HASHIBUZZAMAN-BHUIYAN/ARCEUS/PICTURES/BACK.jpg

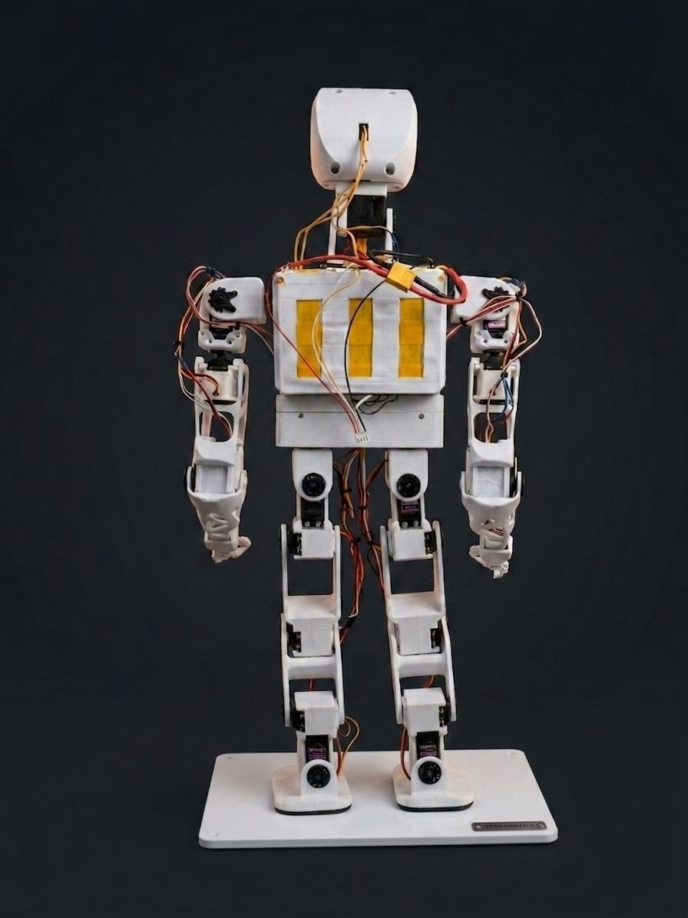
PICTURES/BACK.jpg
