HASHIBUZZAMAN-BHUIYAN/ARCEUS/PICTURES/FRONT.jpg

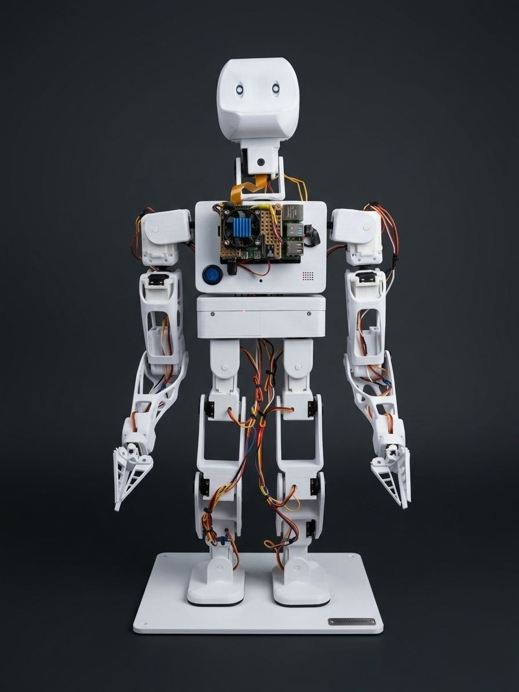
PICTURES/FRONT.jpg
