HASHIBUZZAMAN-BHUIYAN/ARCEUS/CIRCUIT DIAGRAM/ARCEUS_CIRCUIT_DIAGRAM.pptx

OLED GND -> Mpu9250 GND

Out(-) –> Raspberry pi GND

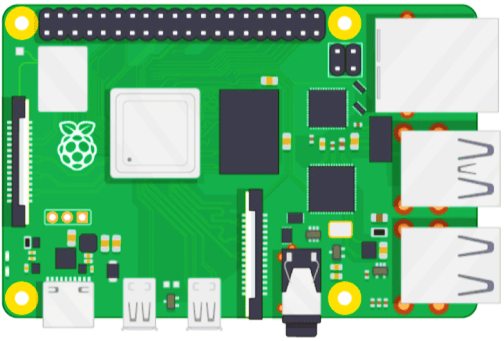
[picture p3: figure]
RASPBERRY PI 4 B SETTING UP Pdf Download | ManualsLib
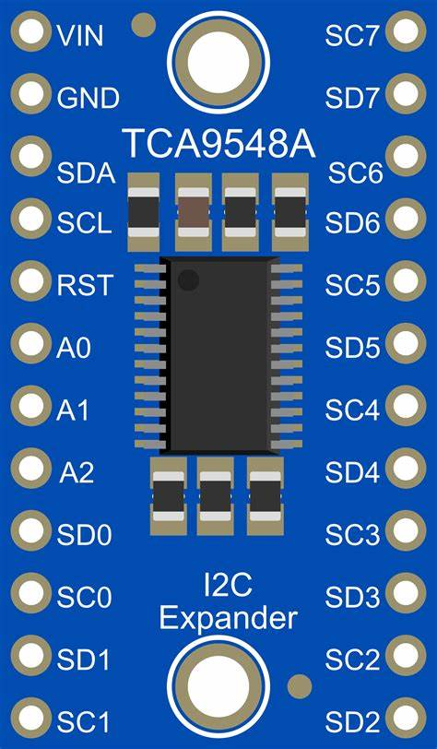
[picture p4: figure]

Sc5- PCA2 scl
Sd5- PCA2 sda

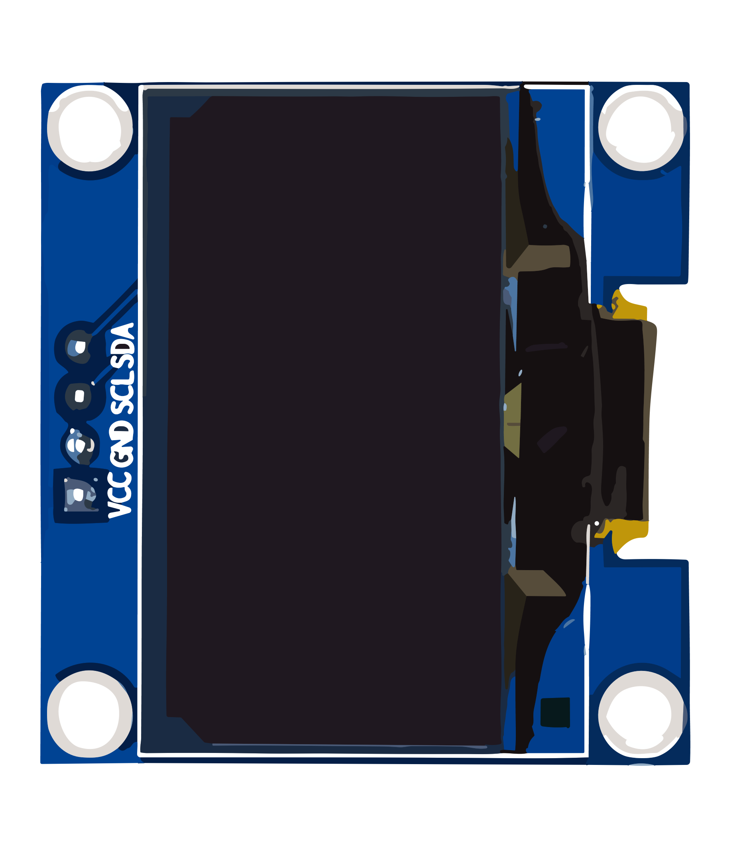
[picture p5: figure]

Two PCA power (2A)

Six Servo Motor power (5.2 A)

Sc5- PCA1 scl
Sd5- PCA1 sda

Sc5- oled scl
Sd5- oled sda

PI 4

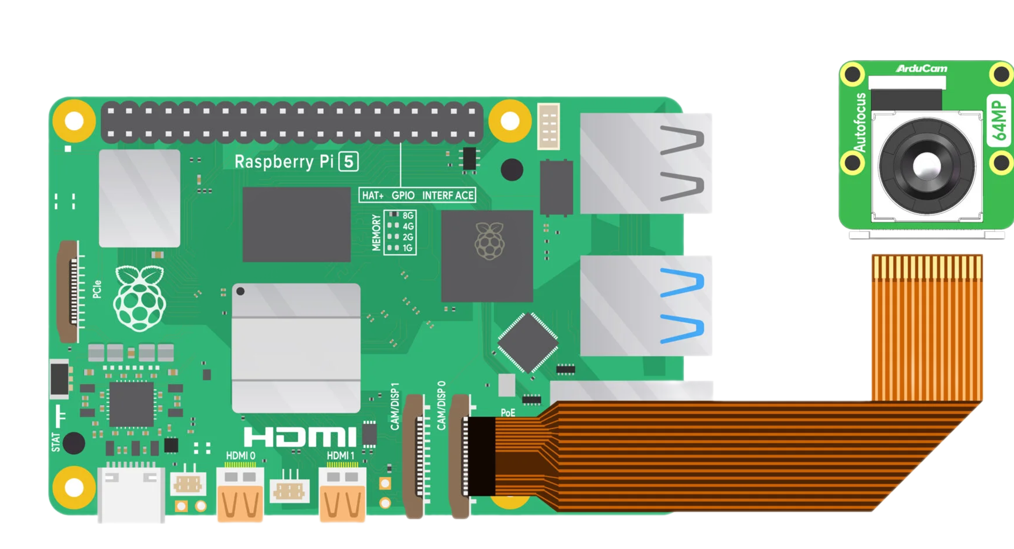
[picture p6: figure]
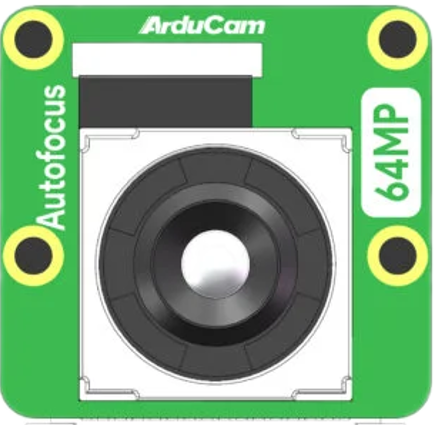
[picture p7: figure]

4B+

USB Audio Drive

Microphone

Speaker

PI 5

Six Servo Motor power (5.2A)

Five Servo Motor power (5A)

0

I

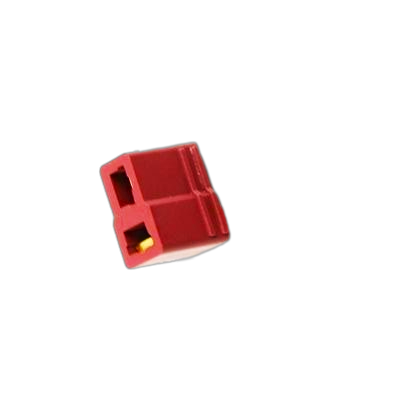
[picture p8: figure]
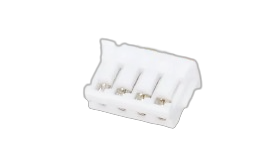
[picture p9: figure]

11.1v, 3s

Lipo battery

ARCEUS CIRCUIT
DIAGRAM

Five Servo Motor power (5A)

Five Servo Motor power (5A)
