HASHIBUZZAMAN-BHUIYAN/ARCEUS/CIRCUIT DIAGRAM/ARCEUS_CIRCUIT_DIAGRAM.png

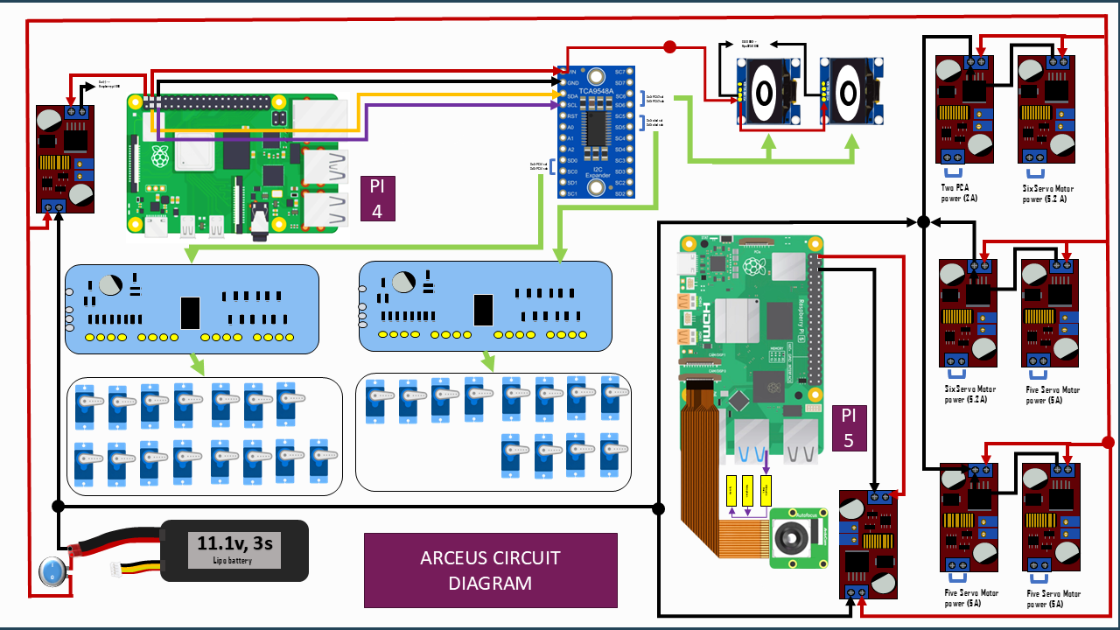
CIRCUIT DIAGRAM/ARCEUS_CIRCUIT_DIAGRAM.png
