HASHIBUZZAMAN-BHUIYAN/ARCEUS/PICTURES/UI PICTURE/PART1.png

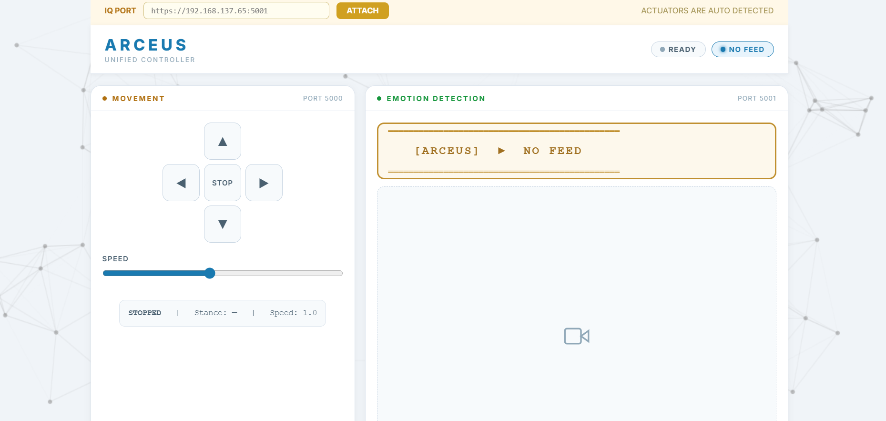
PICTURES/UI PICTURE/PART1.png
