HASHIBUZZAMAN-BHUIYAN/ARCEUS/PICTURES/UI PICTURE/PART2.png

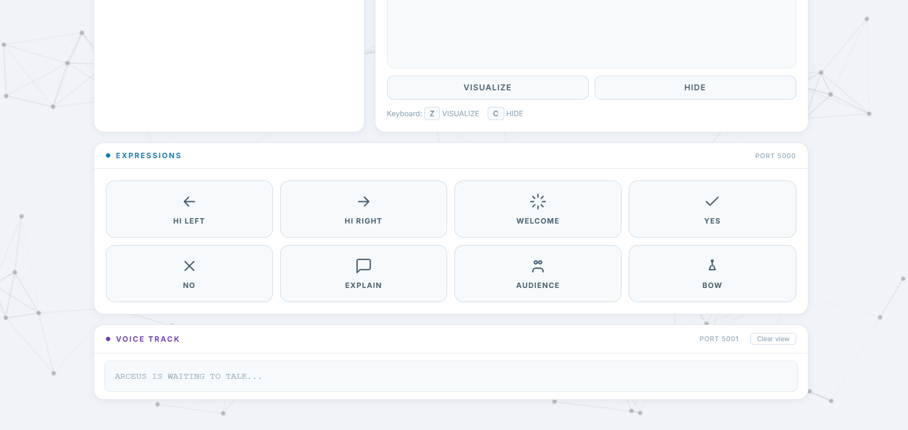
PICTURES/UI PICTURE/PART2.png
