HASHIBUZZAMAN-BHUIYAN/ARCEUS/GCODE/Guideline.txt

These G-code Files will only work on Creality Ender V3 SE 3D printer.
