HASHIBUZZAMAN-BHUIYAN/ARCEUS/CIRCUIT DIAGRAM/ARCEUS_CIRCUIT_DIAGRAM.pdf

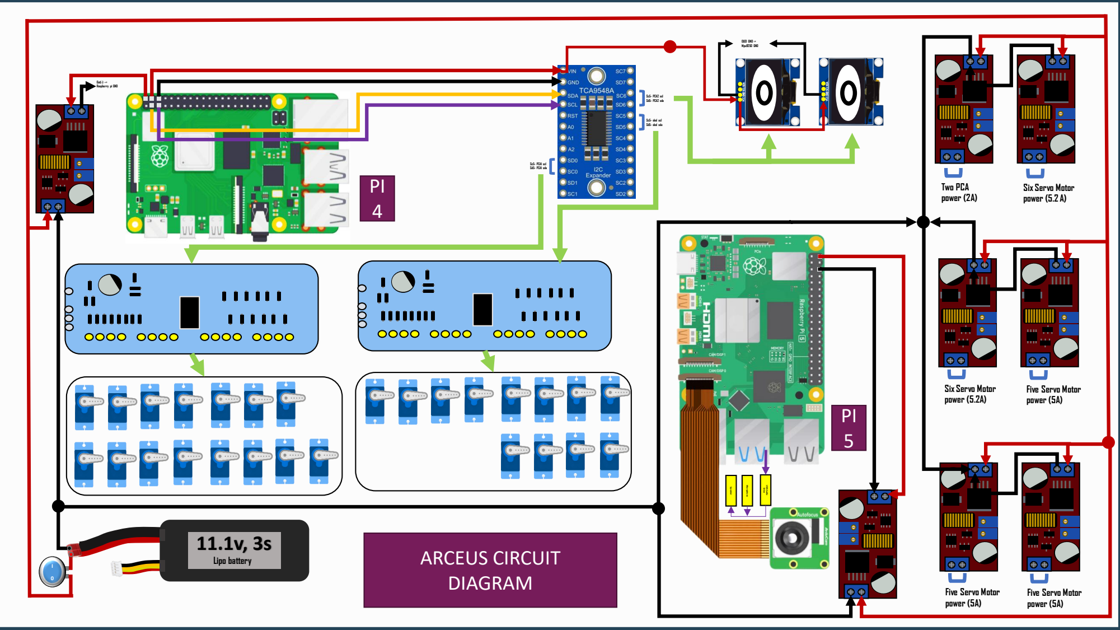
[picture p13: page 1]
Lipo battery I; Sc5- oled scl Sd5- oled sda; Sc5- PCA2 scl Sd5- PCA2 sda; Sc5- PCA1 scl Sd5- PCA1 sda; OLED GND -> Mpu9250 GND; Two PCA power (2A); USB Audio; Drive; Microphone; Speaker; ARCEUS CIRCUIT DIAGRAM

Out(-) –>
Raspberry pi GND

Six Servo Motor
power (5.2 A)

power (5.2A)

Five Servo Motor
power (5A)
